aalonsopuig/Sonar/README.md

<html>

<head>
<meta http-equiv="Content-Language" content="es">
<meta name="GENERATOR" content="Microsoft FrontPage 4.0">
<meta name="ProgId" content="FrontPage.Editor.Document">
</head>

<font size="4"><b><i>Diseño y aplicación de un Sonar de
      barrido.&nbsp;</i></b></font>
      <p>Por Alejandro Alonso Puig<br>
      Diciembre 2.003<br>
      </p>
<hr>
<p align="justify"><br>
El siguiente repositorio incorpora los programas y un informe técnico que describe el diseño de un sonar de barrido y su
aplicación para generar planos polares y de profundidad</p>
<p align="justify">El objetivo de este trabajo ha sido mostrar de una forma
sencilla y gráfica el modo en que se percibe el entorno mediante
emisores-receptores de ultrasonidos.</p>
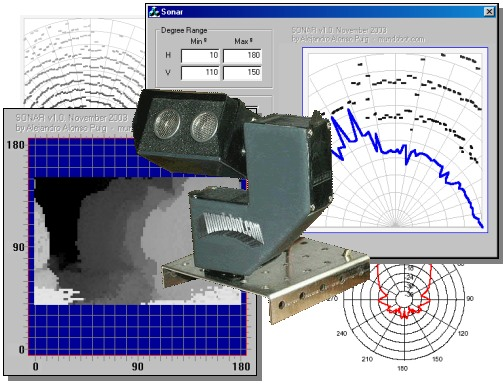
[picture p1: Compose2.jpg]

<p align="justify">Se hará mención a todos los aspectos
Hardware y Software, así como conclusiones de la experiencia.</p>
<p align="justify">El trabajo desarrollado no pretende más que ser una
introducción al manejo de las mediciones ultrasónicas de distancia.</p>
<p align="justify">Las medidas tomadas y los mapas mostrados son simples, esto
es, sin tratamientos avanzados de la señal para aumentar la precisión de los
mismos.</p>
