aalonsopuig/Sonar/Sonar programa/resource.h

//{{NO_DEPENDENCIES}}
// Microsoft Developer Studio generated include file.
// Used by Sonar.rc
//
#define IDD_SONAR_DIALOG                102
#define IDR_MAINFRAME                   128
#define IDC_HAngleMin                   1000
#define IDC_HAngleMax                   1001
#define IDC_VAngleMax                   1002
#define IDC_VAngleMin                   1003
#define IDC_DistMax                     1005
#define IDC_Resol                       1006
#define IDC_DepthMap                    1010
#define IDC_PolarMap                    1011
#define IDC_Help                        1012
#define IDC_ResSw                       1014
#define IDC_DepthSw                     1015

// Next default values for new objects
// 
#ifdef APSTUDIO_INVOKED
#ifndef APSTUDIO_READONLY_SYMBOLS
#define _APS_NEXT_RESOURCE_VALUE        129
#define _APS_NEXT_COMMAND_VALUE         32771
#define _APS_NEXT_CONTROL_VALUE         1017
#define _APS_NEXT_SYMED_VALUE           101
#endif
#endif
